AGH-Marines/szczupak_led_controller/hardware/szczupak_led_controller/szczupak_led_controller.kicad_pcb

## KiCad design hardware/szczupak_led_controller/szczupak_led_controller.kicad_pcb (2026-07-15)

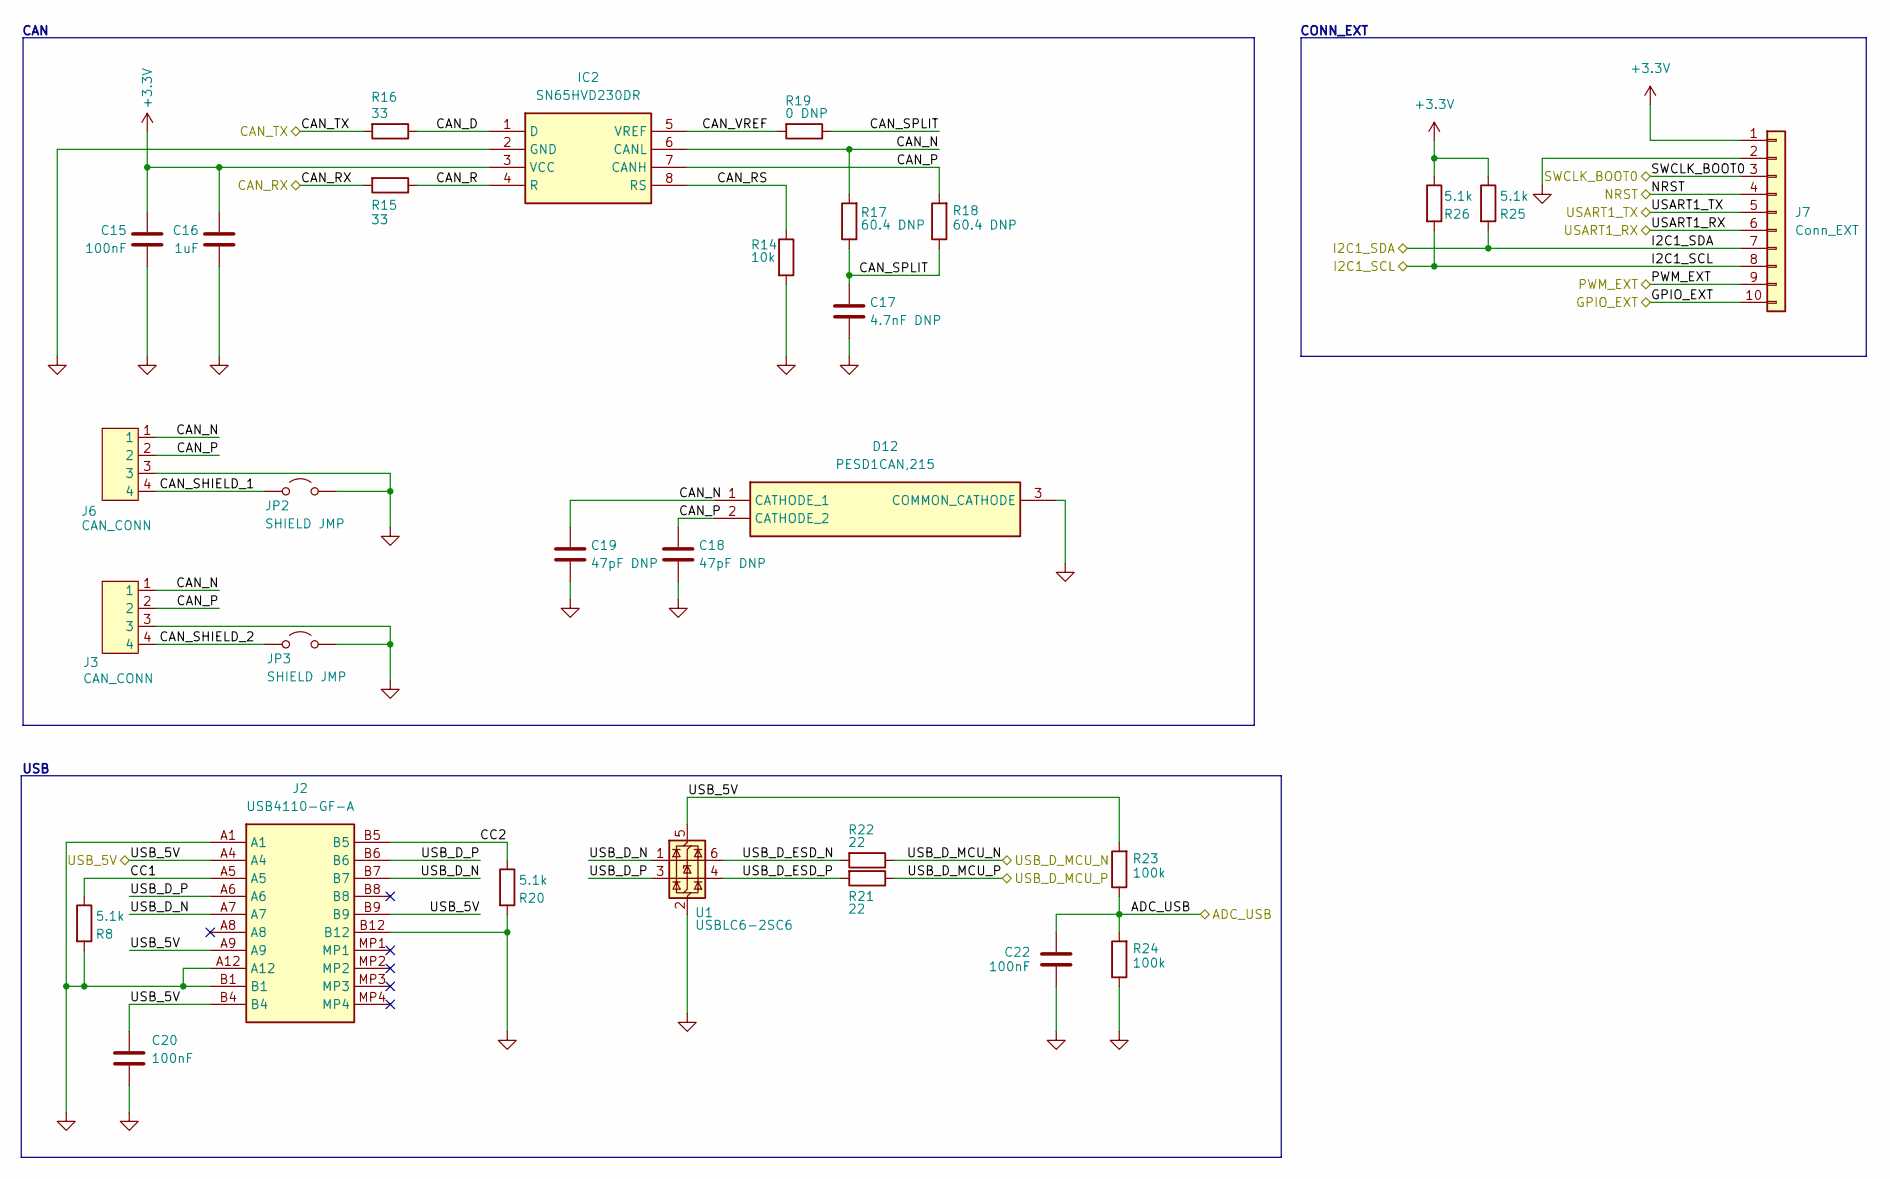
[picture p1: schematic 03_interfaces.kicad_sch, szczupak_led_controller - 03_interfaces]

Parts:
C15, C20, C22: 100nF; C_0603_1608Metric
C16: 1uF; C_0805_2012Metric
C17: 4.7nF DNP; C_0603_1608Metric
C18, C19: 47pF DNP; C_0603_1608Metric
D12: PESD1CAN,215; SOT95P230X110-3N; Manufacturer_Part_Number PESD1CAN,215
IC2: SN65HVD230DR; SOT127P600X175-8N; Manufacturer_Part_Number SN65HVD230DR; Mouser Part Number 595-SN65HVD230DR
J2: USB4110-GF-A; USB4110GFA; Manufacturer_Part_Number USB4110-GF-A
J3, J6: CAN_CONN; XY2500V-D(5.08)-4PIN
J7: Conn_EXT; PinHeader_1x10_P2.54mm_Vertical
JP2, JP3: SHIELD JMP; SolderJumper-2_P1.3mm_Open_TrianglePad1.0x1.5mm
R8, R20, R25, R26: 5.1k; R_0603_1608Metric
R14: 10k; R_0603_1608Metric
R15, R16: 33; R_0603_1608Metric
R17, R18: 60.4 DNP; R_0805_2012Metric
R19: 0 DNP; R_0603_1608Metric
R21, R22: 22; R_0603_1608Metric
R23, R24: 100k; R_0603_1608Metric
U1: USBLC6-2SC6; SOT-23-6

Connections:
+3.3V: C15.1, C16.1, IC2.3 (VCC), J7.1, R25.1, R26.1; also elsewhere on the board
/03_interfaces/CAN_D: IC2.1 (D), R16.1
/03_interfaces/CAN_N: C19.1, D12.1 (CATHODE_1), IC2.6 (CANL), J3.1, J6.1, R17.2
/03_interfaces/CAN_P: C18.1, D12.2 (CATHODE_2), IC2.7 (CANH), J3.2, J6.2, R18.2
/03_interfaces/CAN_R: IC2.4 (R), R15.1
/03_interfaces/CAN_RS: IC2.8 (RS), R14.1
/03_interfaces/CAN_SHIELD_1: J6.4, JP2.1 (A)
/03_interfaces/CAN_SHIELD_2: J3.4, JP3.1 (A)
/03_interfaces/CAN_SPLIT: C17.1, R17.1, R18.1, R19.1
/03_interfaces/CAN_VREF: IC2.5 (VREF), R19.2
/03_interfaces/CC1: J2.A5, R8.1
/03_interfaces/CC2: J2.B5, R20.1
/03_interfaces/USB_D_ESD_N: R22.2, U1.6 (I/O1)
/03_interfaces/USB_D_ESD_P: R21.2, U1.4 (I/O2)
/03_interfaces/USB_D_N: J2.A7, J2.B7, U1.1 (I/O1)
/03_interfaces/USB_D_P: J2.A6, J2.B6, U1.3 (I/O2)
/ADC_USB: C22.1, R23.1, R24.2; also elsewhere on the board
/CAN_RX: R15.2; also elsewhere on the board
/CAN_TX: R16.2; also elsewhere on the board
/GPIO_EXT: J7.10; also elsewhere on the board
/I2C1_SCL: J7.8, R26.2; also elsewhere on the board
/I2C1_SDA: J7.7, R25.2; also elsewhere on the board
/NRST: J7.4; also elsewhere on the board
/PWM_EXT: J7.9; also elsewhere on the board
/SWCLK_BOOT0: J7.3; also elsewhere on the board
/USART1_RX: J7.6; also elsewhere on the board
/USART1_TX: J7.5; also elsewhere on the board
/USB_5V: C20.1, J2.A4, J2.A9, J2.B4, J2.B9, R23.2, U1.5 (VBUS); also elsewhere on the board
/USB_D_MCU_N: R22.1; also elsewhere on the board
/USB_D_MCU_P: R21.1; also elsewhere on the board
GND: C15.2, C16.2, C17.2, C18.2, C19.2, C20.2, C22.2, D12.3 (COMMON_CATHODE), IC2.2 (GND), J2.A1, J2.A12, J2.B1, J2.B12, J3.3, J6.3, J7.2, JP2.2 (B), JP3.2 (B), R8.2, R14.2, R20.2, R24.1, U1.2 (GND); also elsewhere on the board

Notes on the sheet:
USB
CONN_EXT
CAN

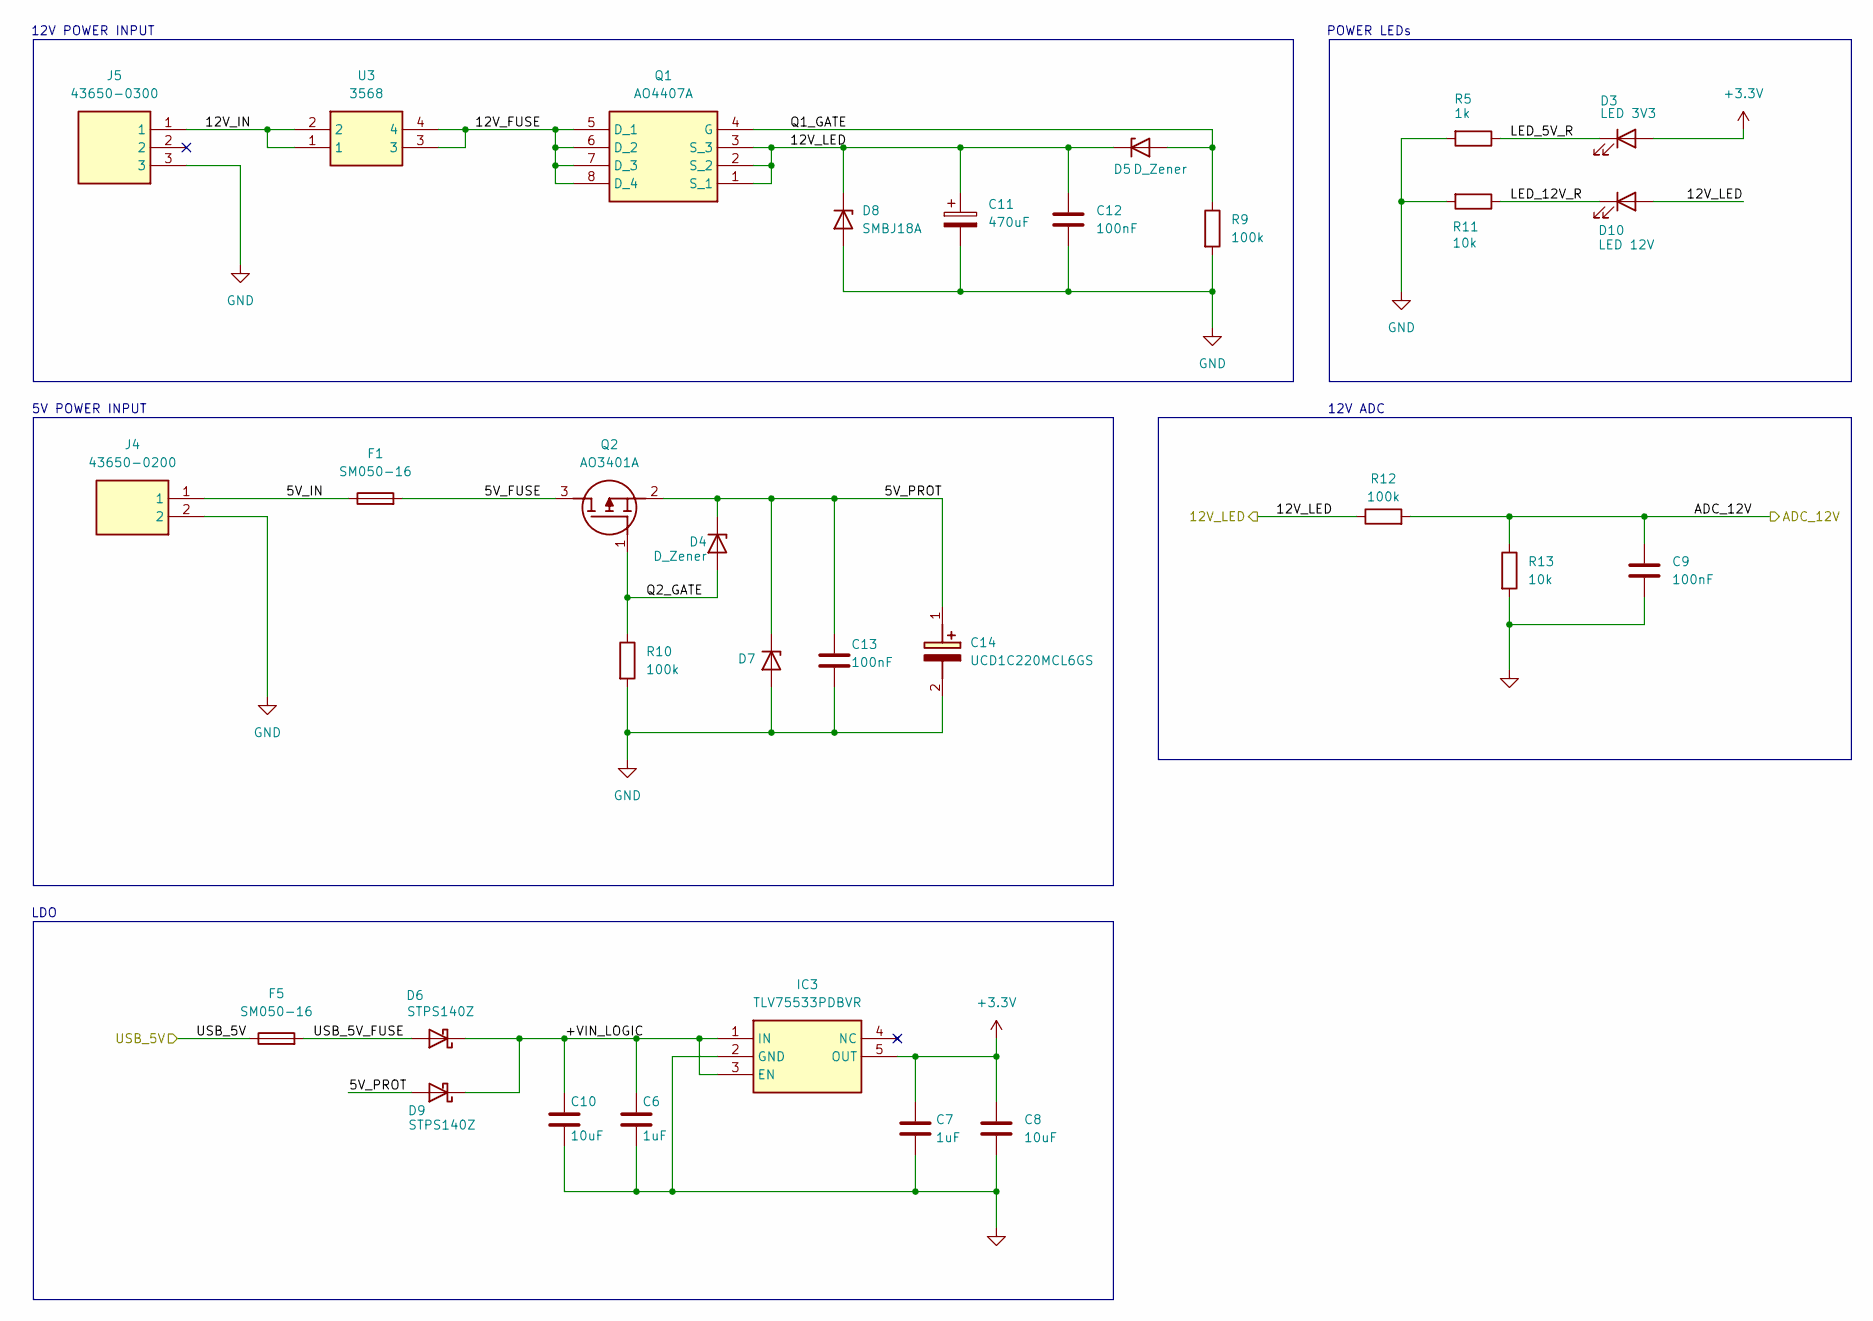
[picture p2: schematic 01_power_input.kicad_sch, led_controller - 01_power_input]

Parts:
C6, C7: 1uF; C_0805_2012Metric
C8, C10: 10uF; C_0805_2012Metric
C9, C12, C13: 100nF; C_0603_1608Metric
C11: 470uF; EEEFK1V331P
C14: UCD1C220MCL6GS; CAPAE430X610N; Manufacturer_Part_Number UCD1C220MCL6GS
D3: LED 3V3; LED_0805_2012Metric
D4, D5: D_Zener; D_SOD-123F
D6, D9: STPS140Z; SOD3816X145N; Manufacturer_Part_Number STPS140Z
D7: SMAJ5.0A-E3_61; DIOM5127X229N
D8: SMBJ18A; D_SMB
D10: LED 12V; LED_0805_2012Metric
F1, F5: SM050-16; Fuse_1210_3225Metric
IC3: TLV75533PDBVR; SOT95P280X145-5N; Manufacturer_Part_Number TLV75533PDBVR
J4: 43650-0200; 43650-02_00,01,02_; Manufacturer_Part_Number 43650-0200
J5: 43650-0300; 436500300; Manufacturer_Part_Number 43650-0300
Q1: AO4407A; SOIC127P600X175-8N; Manufacturer_Part_Number AO4407A
Q2: AO3401A; SOT95P280X125-3N; Manufacturer_Part_Number AO3401A
R5: 1k; R_0603_1608Metric
R9, R10, R12: 100k; R_0603_1608Metric
R11, R13: 10k; R_0603_1608Metric
U3: 3568; Manufacturer_Part_Number 3568

Connections:
+3.3V: C7.1, C8.1, D3.2 (A), IC3.5 (OUT); also elsewhere on the board
/01_power_input/5V_FUSE: F1.2, Q2.3 (D)
/01_power_input/5V_IN: F1.1, J4.1
/01_power_input/5V_PROT: C13.1, C14.1 (+), D4.1 (K), D7.1 (K), D9.2 (A), Q2.2 (S)
/01_power_input/12V_FUSE: Q1.5 (D_1), Q1.6 (D_2), Q1.7 (D_3), Q1.8 (D_4), U3.3, U3.4
/01_power_input/12V_IN: J5.1, U3.1, U3.2
/01_power_input/+VIN_LOGIC: C6.1, C10.1, D6.1 (K), D9.1 (K), IC3.1 (IN), IC3.3 (EN)
/01_power_input/LED_5V_R: D3.1 (K), R5.1
/01_power_input/LED_12V_R: D10.1 (K), R11.1
/01_power_input/Q1_GATE: D5.2 (A), Q1.4 (G), R9.1
/01_power_input/Q2_GATE: D4.2 (A), Q2.1 (G), R10.1
/01_power_input/USB_5V_FUSE: D6.2 (A), F5.2
/12V_LED: C11.1, C12.1, D5.1 (K), D8.1 (K), D10.2 (A), Q1.1 (S_1), Q1.2 (S_2), Q1.3 (S_3), R12.1; also elsewhere on the board
/ADC_12V: C9.1, R12.2, R13.1; also elsewhere on the board
/USB_5V: F5.1; also elsewhere on the board
GND: C6.2, C7.2, C8.2, C9.2, C10.2, C11.2, C12.2, C13.2, C14.2 (-), D7.2 (A), D8.2 (A), IC3.2 (GND), J4.2, J5.3, R5.2, R9.2, R10.2, R11.2, R13.2; also elsewhere on the board

Notes on the sheet:
POWER LEDs
12V ADC
5V POWER INPUT
LDO
12V POWER INPUT

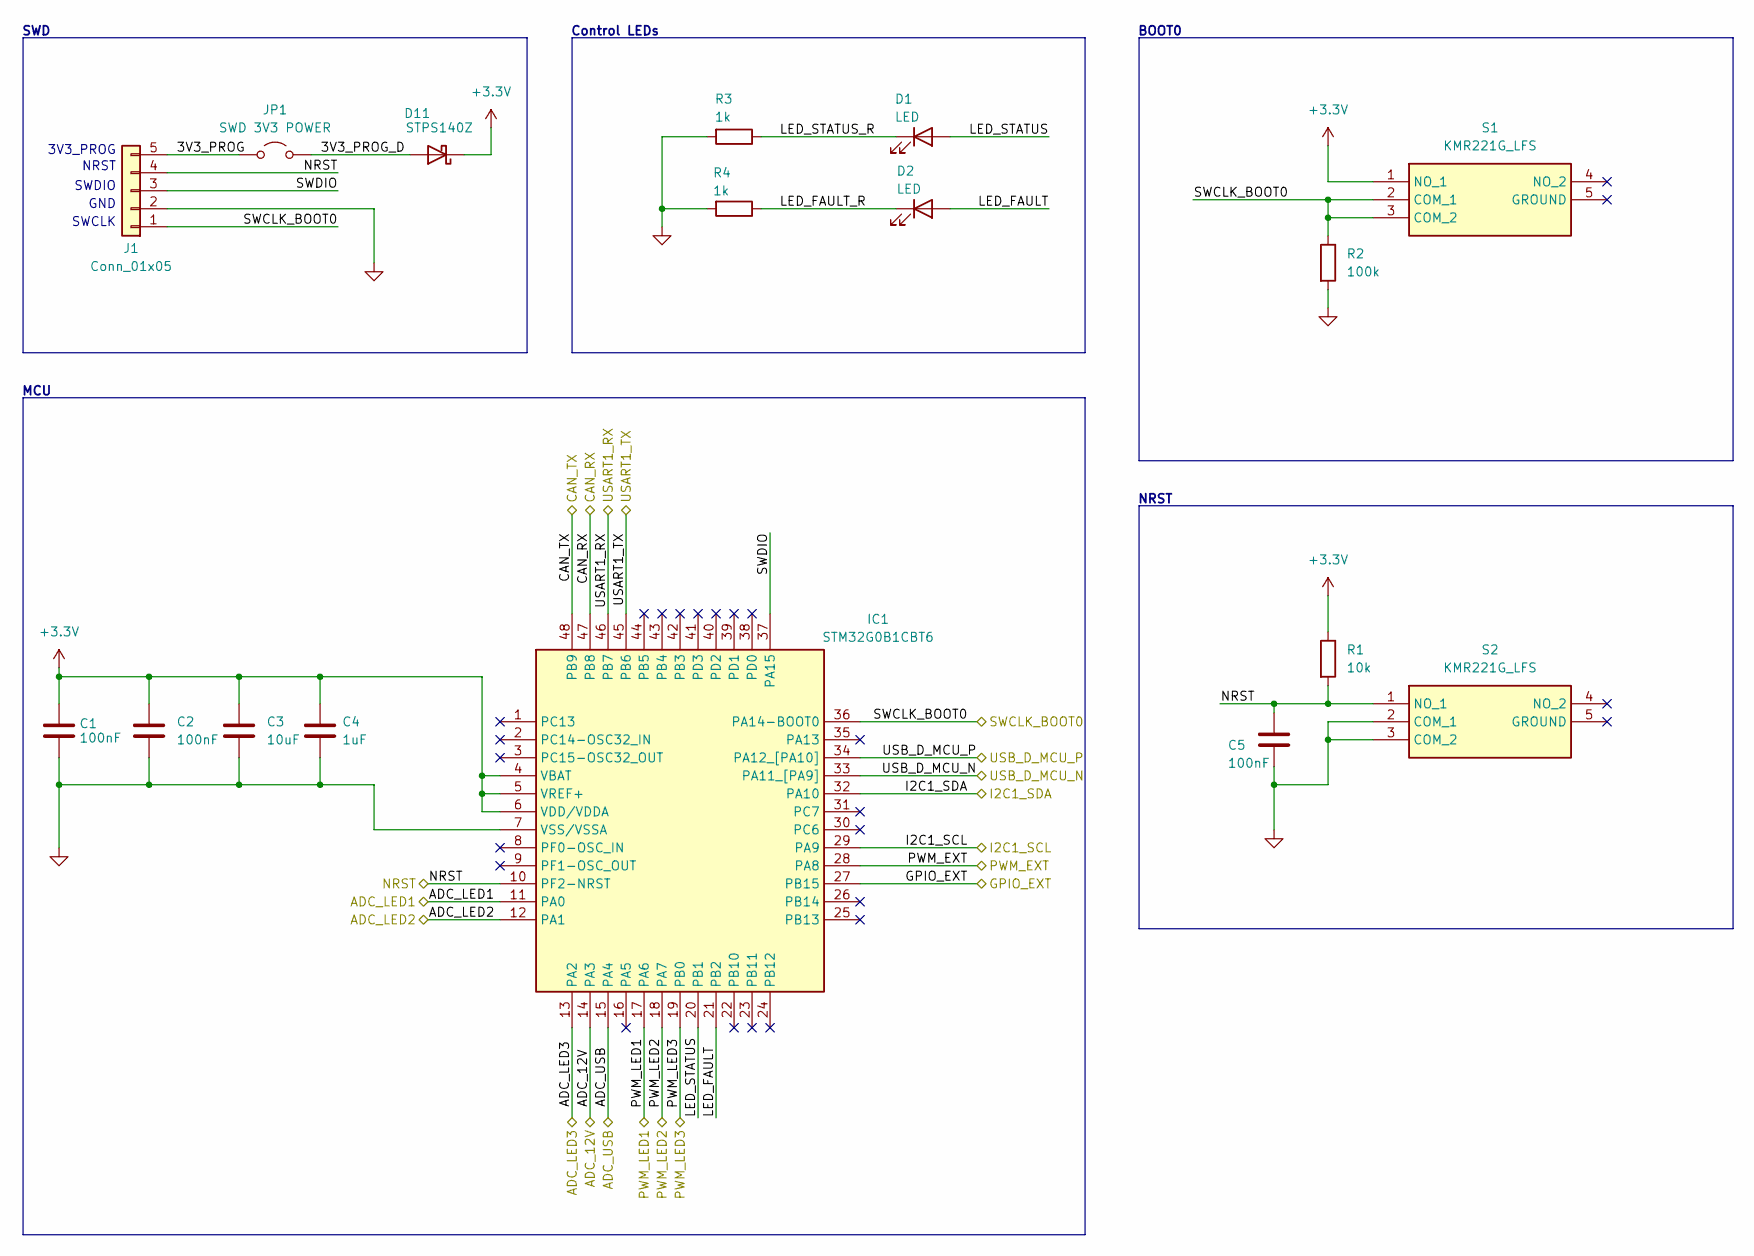
[picture p3: schematic 02_mcu.kicad_sch, szczupak_led_controller - 02_mcu]

Parts:
C1, C2, C5: 100nF; C_0603_1608Metric
C3: 10uF; C_0805_2012Metric
C4: 1uF; C_0805_2012Metric
D1, D2: LED; LED_0805_2012Metric
D11: STPS140Z; SOD3816X145N; Manufacturer_Part_Number STPS140Z
IC1: STM32G0B1CBT6; QFP50P900X900X160-48N; Manufacturer_Part_Number STM32G0B1CBT6
J1: Conn_01x05; PinHeader_1x05_P2.54mm_Vertical
JP1: SWD 3V3 POWER; SolderJumper-2_P1.3mm_Open_TrianglePad1.0x1.5mm
R1: 10k; R_0603_1608Metric
R2: 100k; R_0603_1608Metric
R3, R4: 1k; R_0603_1608Metric
S1, S2: KMR221G_LFS; KMR221GLFS; Manufacturer_Part_Number KMR221G LFS

Connections:
+3.3V: C1.1, C2.1, C3.1, C4.1, D11.1 (K), IC1.4 (VBAT), IC1.5 (VREF+), IC1.6 (VDD/VDDA), R1.1, S1.1 (NO_1); also elsewhere on the board
/02_mcu/3V3_PROG: J1.5, JP1.1 (A)
/02_mcu/3V3_PROG_D: D11.2 (A), JP1.2 (B)
/02_mcu/LED_FAULT: D2.2 (A), IC1.21 (PB2)
/02_mcu/LED_FAULT_R: D2.1 (K), R4.1
/02_mcu/LED_STATUS: D1.2 (A), IC1.20 (PB1)
/02_mcu/LED_STATUS_R: D1.1 (K), R3.1
/02_mcu/SWDIO: IC1.37 (PA15), J1.3
/ADC_12V: IC1.14 (PA3); also elsewhere on the board
/ADC_LED1: IC1.11 (PA0); also elsewhere on the board
/ADC_LED2: IC1.12 (PA1); also elsewhere on the board
/ADC_LED3: IC1.13 (PA2); also elsewhere on the board
/ADC_USB: IC1.15 (PA4); also elsewhere on the board
/CAN_RX: IC1.47 (PB8); also elsewhere on the board
/CAN_TX: IC1.48 (PB9); also elsewhere on the board
/GPIO_EXT: IC1.27 (PB15); also elsewhere on the board
/I2C1_SCL: IC1.29 (PA9); also elsewhere on the board
/I2C1_SDA: IC1.32 (PA10); also elsewhere on the board
/NRST: C5.1, IC1.10 (PF2-NRST), J1.4, R1.2, S2.1 (NO_1); also elsewhere on the board
/PWM_EXT: IC1.28 (PA8); also elsewhere on the board
/PWM_LED1: IC1.17 (PA6); also elsewhere on the board
/PWM_LED2: IC1.18 (PA7); also elsewhere on the board
/PWM_LED3: IC1.19 (PB0); also elsewhere on the board
/SWCLK_BOOT0: IC1.36 (PA14-BOOT0), J1.1, R2.1, S1.2 (COM_1), S1.3 (COM_2); also elsewhere on the board
/USART1_RX: IC1.46 (PB7); also elsewhere on the board
/USART1_TX: IC1.45 (PB6); also elsewhere on the board
/USB_D_MCU_N: IC1.33 (PA11_[PA9]); also elsewhere on the board
/USB_D_MCU_P: IC1.34 (PA12_[PA10]); also elsewhere on the board
GND: C1.2, C2.2, C3.2, C4.2, C5.2, IC1.7 (VSS/VSSA), J1.2, R2.2, R3.2, R4.2, S2.2 (COM_1), S2.3 (COM_2); also elsewhere on the board

Notes on the sheet:
SWCLK
MCU
BOOT0
Control LEDs
NRST
SWDIO
NRST
SWD
3V3_PROG
GND

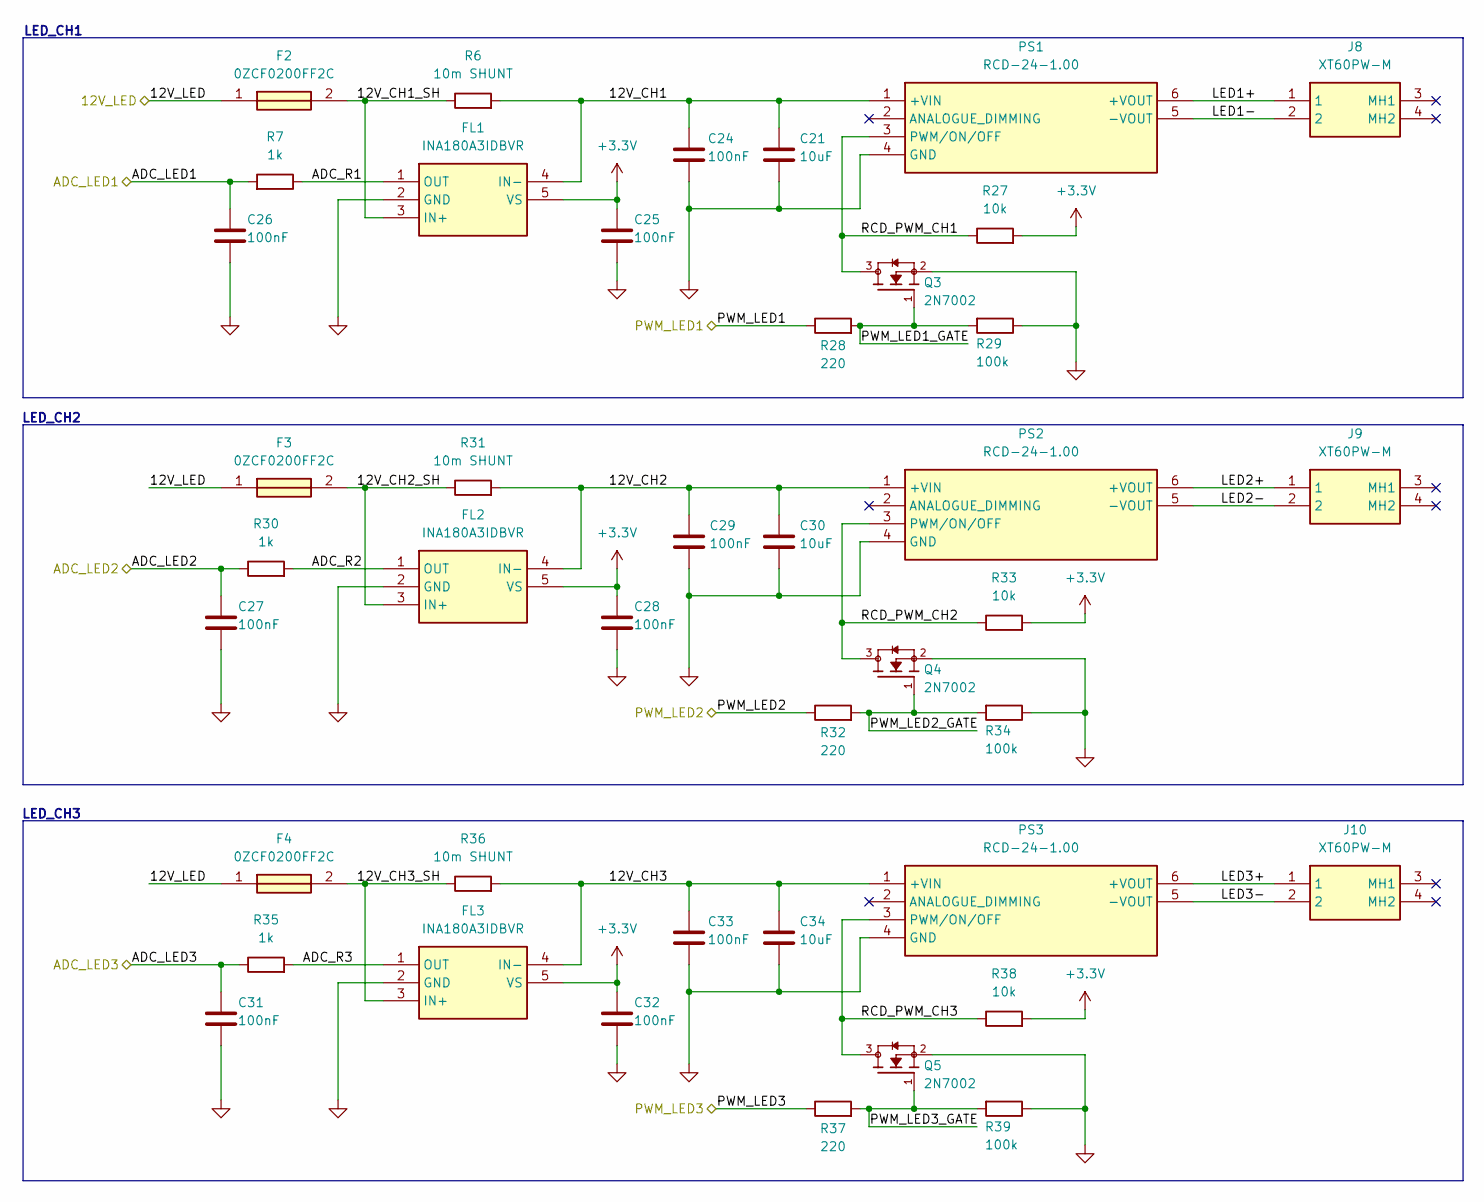
[picture p4: schematic 04_power_output.kicad_sch, szczupak_led_controller - 04_power_output]

Parts:
C21, C30, C34: 10uF; C_0805_2012Metric
C24, C25, C26, C27, C28, C29, C31, C32, C33: 100nF; C_0603_1608Metric
F2, F3, F4: 0ZCF0200FF2C; FUSC7451X90N; Manufacturer_Part_Number 0ZCF0200FF2C
FL1, FL2, FL3: INA180A3IDBVR; SOT95P280X145-5N; Manufacturer_Part_Number INA180A3IDBVR
J8, J9, J10: XT60PW-M; XT60PWM_shorter; Manufacturer_Part_Number XT60PW-M
PS1, PS2, PS3: RCD-24-1.00; RCD24030; Manufacturer_Part_Number RCD-24-1.00
Q3, Q4, Q5: 2N7002; TRANS_2N7002; PARTREV 2023-01-11
R6, R31, R36: 10m SHUNT; R_2512_6332Metric
R7, R30, R35: 1k; R_0603_1608Metric
R27, R33, R38: 10k; R_0603_1608Metric
R28, R32, R37: 220; R_0603_1608Metric
R29, R34, R39: 100k; R_0603_1608Metric

Connections:
+3.3V: C25.1, C28.1, C32.1, FL1.5 (VS), FL2.5 (VS), FL3.5 (VS), R27.2, R33.2, R38.2; also elsewhere on the board
/04_power_output/12V_CH1: C21.1, C24.1, FL1.4 (IN-), PS1.1 (+VIN), R6.2
/04_power_output/12V_CH1_SH: F2.2, FL1.3 (IN+), R6.1
/04_power_output/12V_CH2: C29.1, C30.1, FL2.4 (IN-), PS2.1 (+VIN), R31.2
/04_power_output/12V_CH2_SH: F3.2, FL2.3 (IN+), R31.1
/04_power_output/12V_CH3: C33.1, C34.1, FL3.4 (IN-), PS3.1 (+VIN), R36.2
/04_power_output/12V_CH3_SH: F4.2, FL3.3 (IN+), R36.1
/04_power_output/ADC_R1: FL1.1 (OUT), R7.1
/04_power_output/ADC_R2: FL2.1 (OUT), R30.2
/04_power_output/ADC_R3: FL3.1 (OUT), R35.2
/04_power_output/LED1+: J8.1, PS1.6 (+VOUT)
/04_power_output/LED1-: J8.2, PS1.5 (-VOUT)
/04_power_output/LED2+: J9.1, PS2.6 (+VOUT)
/04_power_output/LED2-: J9.2, PS2.5 (-VOUT)
/04_power_output/LED3+: J10.1, PS3.6 (+VOUT)
/04_power_output/LED3-: J10.2, PS3.5 (-VOUT)
/04_power_output/PWM_LED1_GATE: Q3.1, R28.2, R29.2
/04_power_output/PWM_LED2_GATE: Q4.1, R32.2, R34.2
/04_power_output/PWM_LED3_GATE: Q5.1, R37.2, R39.2
/04_power_output/RCD_PWM_CH1: PS1.3 (PWM/ON/OFF), Q3.3, R27.1
/04_power_output/RCD_PWM_CH2: PS2.3 (PWM/ON/OFF), Q4.3, R33.1
/04_power_output/RCD_PWM_CH3: PS3.3 (PWM/ON/OFF), Q5.3, R38.1
/12V_LED: F2.1, F3.1, F4.1; also elsewhere on the board
/ADC_LED1: C26.1, R7.2; also elsewhere on the board
/ADC_LED2: C27.1, R30.1; also elsewhere on the board
/ADC_LED3: C31.1, R35.1; also elsewhere on the board
/PWM_LED1: R28.1; also elsewhere on the board
/PWM_LED2: R32.1; also elsewhere on the board
/PWM_LED3: R37.1; also elsewhere on the board
GND: C21.2, C24.2, C25.2, C26.2, C27.2, C28.2, C29.2, C30.2, C31.2, C32.2, C33.2, C34.2, FL1.2 (GND), FL2.2 (GND), FL3.2 (GND), PS1.4 (GND), PS2.4 (GND), PS3.4 (GND), Q3.2, Q4.2, Q5.2, R29.1, R34.1, R39.1; also elsewhere on the board

Notes on the sheet:
LED_CH1
LED_CH2
LED_CH3

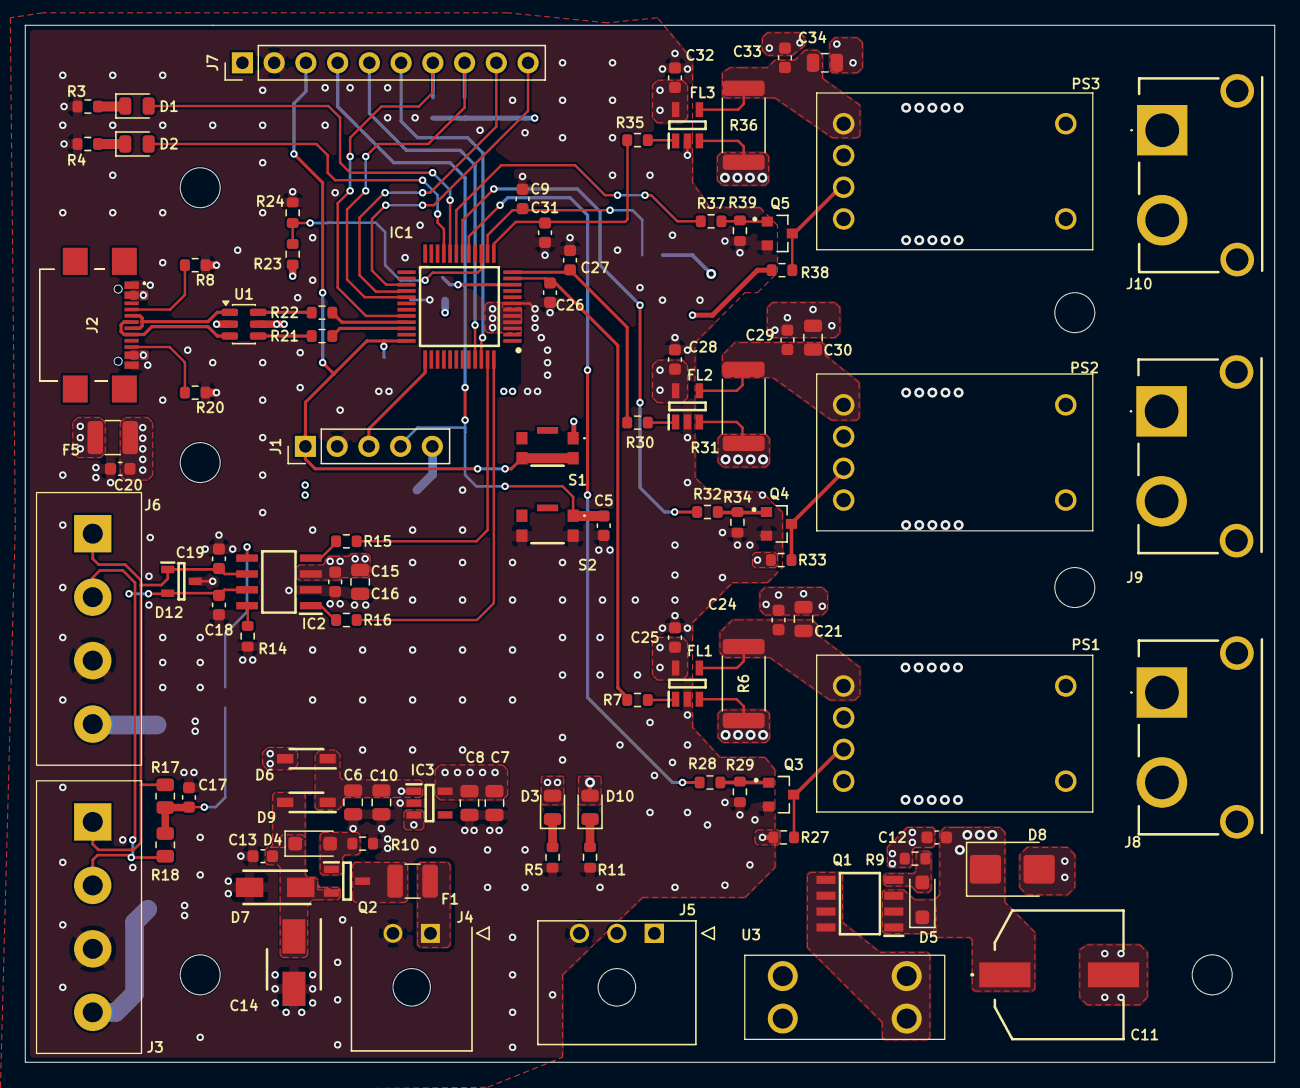
[picture p5: board szczupak_led_controller.kicad_pcb from above]

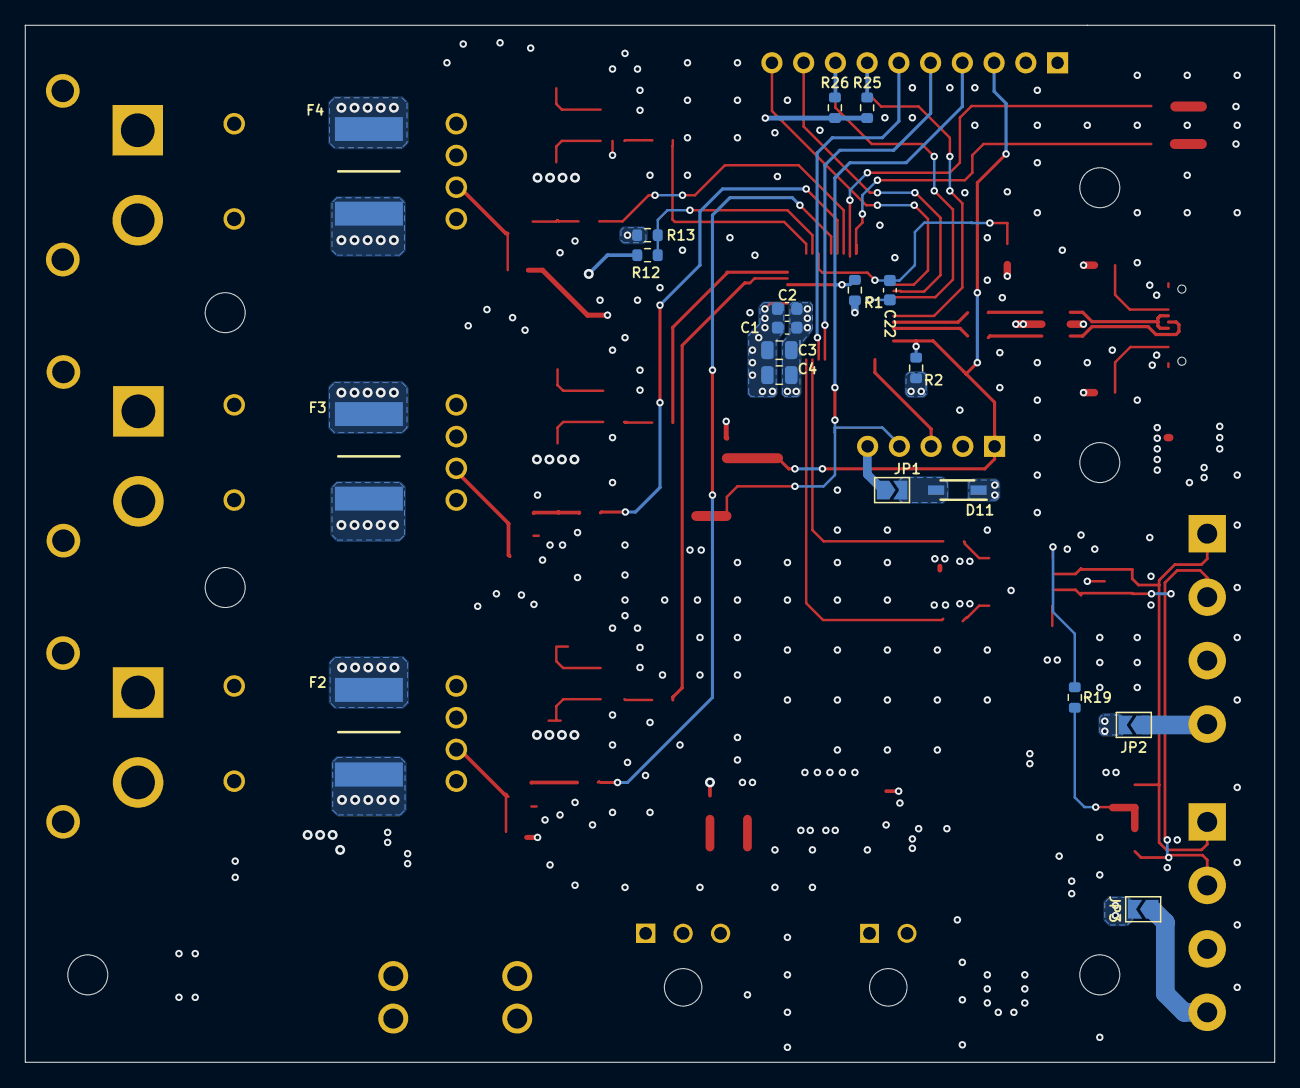
[picture p6: board szczupak_led_controller.kicad_pcb from below]

Board: 4 copper layers, 100.0 x 83.0 mm, 120 parts (19 on the bottom side), 78 nets.
