AGH-Marines/szczupak_led_controller/(commit log)

2026-07-04 #1 #2 created basic repository structure and kicad project
    [01_power_input.kicad_sch, 02_mcu.kicad_sch, 03_interfaces.kicad_sch, szczupak_led_controller.kicad_pcb, szczupak_led_controller.kicad_sch]
2026-07-04 linked libraries and created pcb stack-up consistent with manufacturer data
    [02_mcu.kicad_sch, szczupak_led_controller.kicad_pcb]
2026-07-04 #3 Added some libraries for basic components in interfaces schematic
    [03_interfaces.kicad_sch, szczupak_led_controller.kicad_pcb]
2026-07-06 #3 added schematic and footprint for CAN connector
2026-07-07 Repository cleanup and merge of two versions of interface_schematic
    [01_power_input.kicad_sch, 02_mcu.kicad_sch, 03_interfaces skopiowane.kicad_sch, 03_interfaces.kicad_sch, szczupak_led_controller.kicad_pcb, szczupak_led_controller.kicad_sch]
2026-07-07 #2 Improved schematic readability
    Added boxes with proper labels and changed some components placement
    [02_mcu.kicad_sch]
2026-07-08 #5 #3 Added first version of power_input schematic with some required libraries
    [01_power_input.kicad_sch, 02_mcu.kicad_sch, 03_interfaces.kicad_sch, szczupak_led_controller.kicad_pcb]
2026-07-12 #4 #6 Added power output and interfaces schematics
    Designed initial placement for most important components on pcb
    [01_power_input.kicad_sch, 02_mcu.kicad_sch, 03_interfaces.kicad_sch, 04_power_output.kicad_sch, szczupak_led_controller.kicad_pcb, szczupak_led_controller.kicad_sch]
2026-07-14 #8 Finished initial component placement on pcb
    [02_mcu.kicad_sch, 03_interfaces.kicad_sch, 04_power_output.kicad_sch, szczupak_led_controller.kicad_pcb, szczupak_led_controller.kicad_sch]
2026-07-14 #8 Added routing for usb and mcu. Started pouring of power elements
    [02_mcu.kicad_sch, 03_interfaces.kicad_sch, 04_power_output.kicad_sch, szczupak_led_controller.kicad_pcb]
2026-07-15 #8 Created first version of pcb design
    All KiCad tests passed, so pcb is ready to review
    [szczupak_led_controller.kicad_pcb]
